mervinhemaraju/robot-rover/arduino/motor_first_test/motor_first_test.ino

// First hardware test: drive all 4 motors via Serial Monitor.
// Commands: F = forward, B = backward, S = stop, L = turn left, R = turn right, E = toggle LED
// Send from Arduino IDE Serial Monitor at 115200 baud.
// Remove Serial.println() calls before writing the real Phase 2 sketch.
//
// Wiring (Arduino pin -> L298N pin):
//   Pin 5  -> ENA   (left motors speed, PWM)
//   Pin 4  -> IN1   (left motors direction)
//   Pin 7  -> IN2   (left motors direction)
//   Pin 6  -> ENB   (right motors speed, PWM)
//   Pin 8  -> IN3   (right motors direction)
//   Pin 9  -> IN4   (right motors direction)
//
// LED: uses onboard LED (pin 13 / LED_BUILTIN). No external wiring needed.
// To use an external LED later: wire long leg (+) via 47 ohm resistor to pin 2,
// short leg (-) to GND. Change LED_PIN to 2.

const int LEFT_EN  = 5;
const int LEFT_IN1 = 4;
const int LEFT_IN2 = 7;
const int RIGHT_EN = 6;
const int RIGHT_IN3 = 8;
const int RIGHT_IN4 = 9;

const int LED_PIN  = LED_BUILTIN;

const int TEST_SPEED = 150;

bool ledState = false;

void stopMotors();
void forward();
void backward();
void turnLeft();
void turnRight();
void toggleLed();

void setup() {
  Serial.begin(115200);

  pinMode(LEFT_EN,   OUTPUT);
  pinMode(LEFT_IN1,  OUTPUT);
  pinMode(LEFT_IN2,  OUTPUT);
  pinMode(RIGHT_EN,  OUTPUT);
  pinMode(RIGHT_IN3, OUTPUT);
  pinMode(RIGHT_IN4, OUTPUT);
  pinMode(LED_PIN,   OUTPUT);

  stopMotors();
  digitalWrite(LED_PIN, LOW);
  Serial.println("Ready. F=forward  B=backward  S=stop  L=left  R=right  E=toggle LED");
}

void loop() {
  if (Serial.available() > 0) {
    char cmd = (char)Serial.read();

    if      (cmd == 'F' || cmd == 'f') forward();
    else if (cmd == 'B' || cmd == 'b') backward();
    else if (cmd == 'S' || cmd == 's') stopMotors();
    else if (cmd == 'L' || cmd == 'l') turnLeft();
    else if (cmd == 'R' || cmd == 'r') turnRight();
    else if (cmd == 'E' || cmd == 'e') toggleLed();
  }
}

void forward() {
  digitalWrite(LEFT_IN1,  HIGH);
  digitalWrite(LEFT_IN2,  LOW);
  digitalWrite(RIGHT_IN3, HIGH);
  digitalWrite(RIGHT_IN4, LOW);
  analogWrite(LEFT_EN,  TEST_SPEED);
  analogWrite(RIGHT_EN, TEST_SPEED);
  Serial.println("Forward");
}

void backward() {
  digitalWrite(LEFT_IN1,  LOW);
  digitalWrite(LEFT_IN2,  HIGH);
  digitalWrite(RIGHT_IN3, LOW);
  digitalWrite(RIGHT_IN4, HIGH);
  analogWrite(LEFT_EN,  TEST_SPEED);
  analogWrite(RIGHT_EN, TEST_SPEED);
  Serial.println("Backward");
}

void stopMotors() {
  digitalWrite(LEFT_IN1,  LOW);
  digitalWrite(LEFT_IN2,  LOW);
  digitalWrite(RIGHT_IN3, LOW);
  digitalWrite(RIGHT_IN4, LOW);
  analogWrite(LEFT_EN,  0);
  analogWrite(RIGHT_EN, 0);
  Serial.println("Stopped");
}

void turnLeft() {
  digitalWrite(LEFT_IN1,  LOW);
  digitalWrite(LEFT_IN2,  HIGH);
  digitalWrite(RIGHT_IN3, HIGH);
  digitalWrite(RIGHT_IN4, LOW);
  analogWrite(LEFT_EN,  TEST_SPEED);
  analogWrite(RIGHT_EN, TEST_SPEED);
  Serial.println("Turn left");
}

void turnRight() {
  digitalWrite(LEFT_IN1,  HIGH);
  digitalWrite(LEFT_IN2,  LOW);
  digitalWrite(RIGHT_IN3, LOW);
  digitalWrite(RIGHT_IN4, HIGH);
  analogWrite(LEFT_EN,  TEST_SPEED);
  analogWrite(RIGHT_EN, TEST_SPEED);
  Serial.println("Turn right");
}

void toggleLed() {
  ledState = !ledState;
  digitalWrite(LED_PIN, ledState ? HIGH : LOW);
  Serial.println(ledState ? "LED on" : "LED off");
}
