mervinhemaraju/robot-rover/(commit log)

2026-06-22 - Started phase 2 requirements - Added a first testing arduino sketch - Added docs for power checks
2026-06-25 - Completed chassis assembly and first arduino motor test
    - Updated inventory with all parts for phase 1 - 3
2026-06-25 - Updated arduino script to turn on / off lights
2026-06-25 - Completed partially wiring of L298N with motors and arduino
2026-06-26 - Completed setup of buck convertor
2026-06-28 - Updates to state. Completed arduino and raspberry pi connection - First test done successfully. - Updated arduino sketch to include turns
2026-06-28 - Phase 2 is now completed with the mounting of the parts
2026-06-29 - Added the webserver socker python script - Updated arduino script that includes the final sketch
2026-06-29 - Updated watchdog so that an idle server no longer logs that startup timeout warnings frequently
    - Updated sketch to add a failsafe when no commands arrive for some time
    [commands.cpp, config.h, watchdog.py]
2026-06-29 - Wired the flutter remote controller app to the RPI connection - Fixed reverse issue in the rpi websocket server
    [mixer.py]
2026-07-04 - Corrected state doc about the arduino's voltage
2026-07-05 - Added python script for pi camera
